DaisyAge12/GEN-SMS2VGA/README.md

# SMS2VGA
A Sega Master System/Genesis 1 RGBS output to VGA adapter

A HUGE shout out to Jeff Chen who inspired me to make this adapter with his Console VGA dongles
and who helped me make this project come to life.
