DaisyAge12/GEN-SMS2VGA/Board Images/Back View.jpg

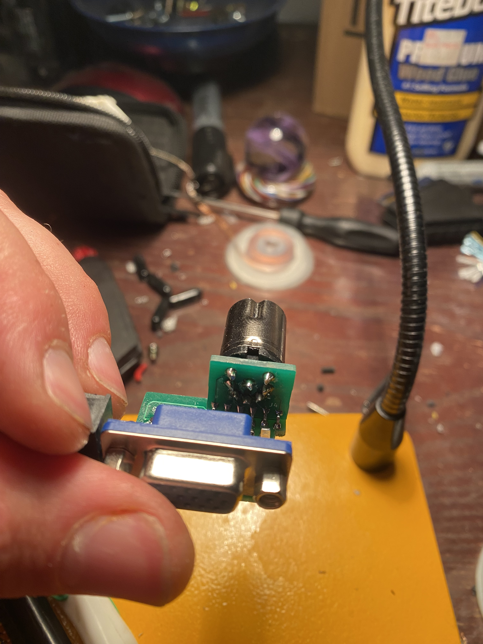
Board Images/Back View.jpg
