DaisyAge12/GEN-SMS2VGA/Board Images/DIN 8 PCB Back.jpg

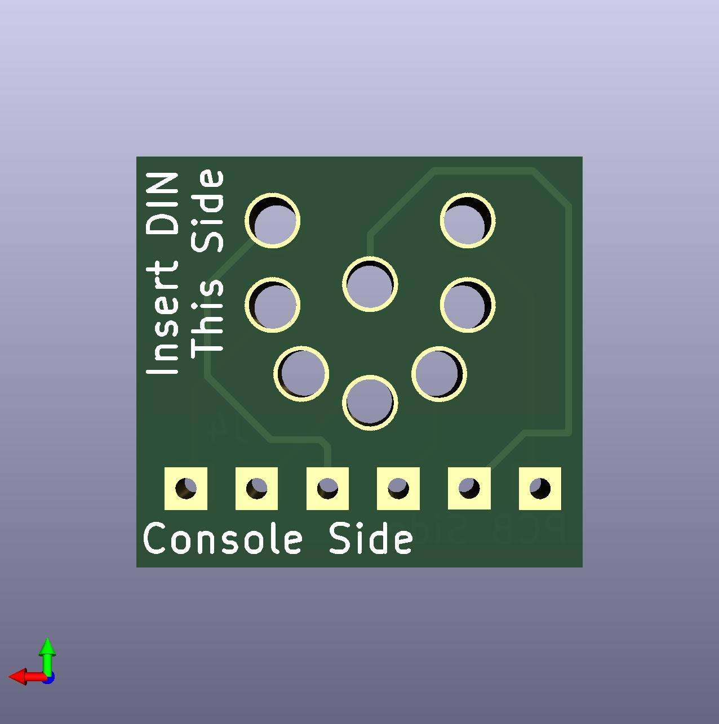
Board Images/DIN 8 PCB Back.jpg
