DaisyAge12/GEN-SMS2VGA/Board Images/DIN 8 PCB Front.jpg

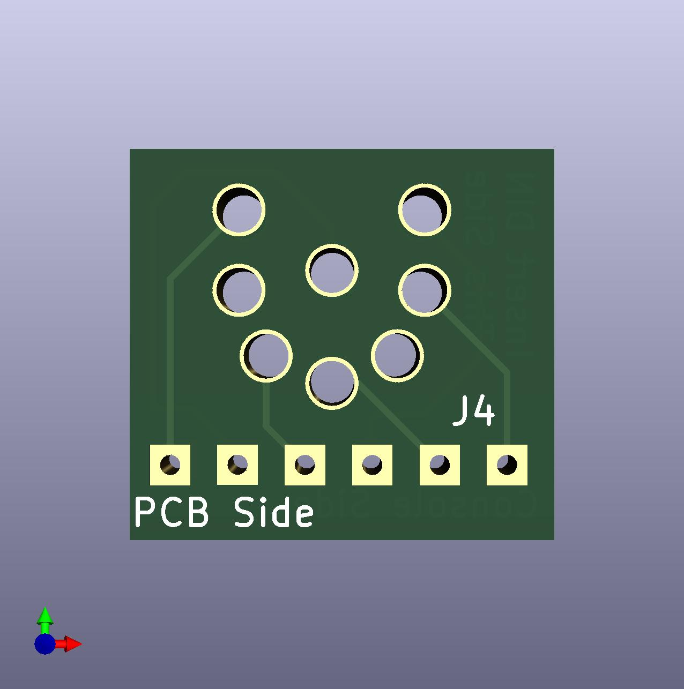
Board Images/DIN 8 PCB Front.jpg
