DaisyAge12/GEN-SMS2VGA/Board Images/SMS2VGA 2.0 Front.jpg

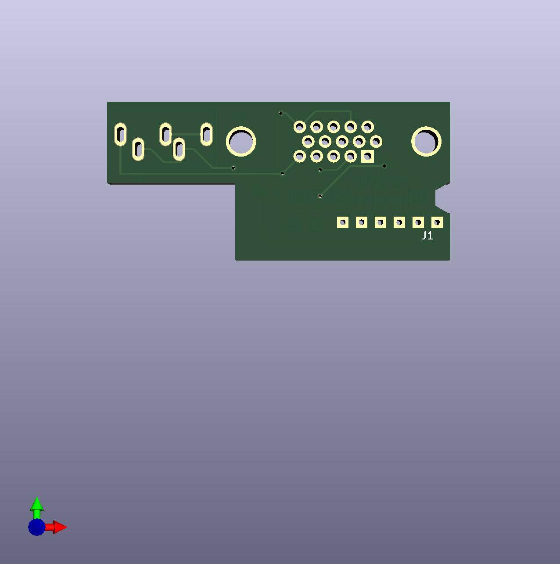
Board Images/SMS2VGA 2.0 Front.jpg
