DaisyAge12/GEN-SMS2VGA/BOM.md

Bill of Materials

M2 hex screw 20mm and nut
Quantity: 2

Right Angle Header Pins 2.54mm Spacing
Digikey part # 609-68498-122HLF-ND
Quantity: 1

Ceramic Capacitor 220UF 6.3V X5R 1206 Imperial
Digikey Part # 490-13970-1-ND
Quantity: 4

Resistor 470 OHM 5% 1/4W 0805 Imperial
Digikey Part # 2019-RK73B2ATTD471JCT-ND
Quantity: 1

Resistor 75 Ohm 1% 1/4W 0805 Imperial
Digikey Part #: 2019-RK73H2ATTD75R0FCT-ND
Quantity: 3

Vertical 3.5mm 5-Pin Audio Jack
Digikey Part # SJ1-3535N
Quantity: 1

Right Angle Female VGA Port Slim (10 pcs)
https://www.aliexpress.com/item/4000596805684.html
Quantity: 1

DIN 8 262 Degree Vertical Connector
https://www.aliexpress.us/item/3256801687296911.html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
Quantity: 1

PCB - SMS2VGA2.0
PCB - DIN 8 PCB

3D printed shell if applicable
