DaisyAge12/GEN-SMS2VGA/SMS2VGA 2.0 Bottom.stl

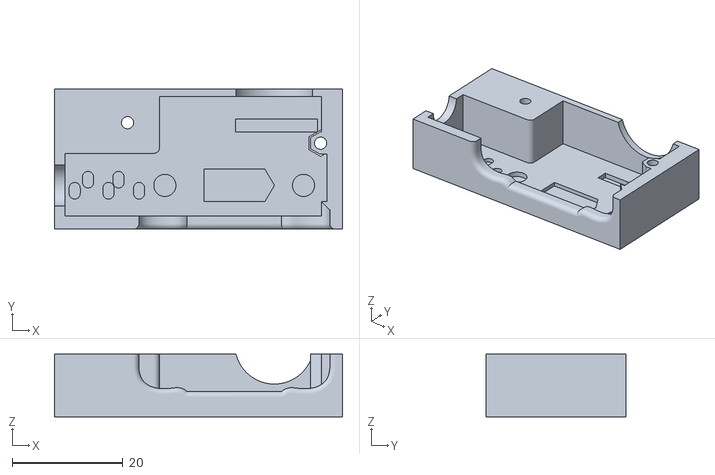
[picture p6: CAD file, 2024-01-08]
SMS2VGA 2.0 Bottom.stl
51.9 x 25.3 x 11.3
