DaisyAge12/GEN-SMS2VGA/SMS2VGA 2.0 Top.stl

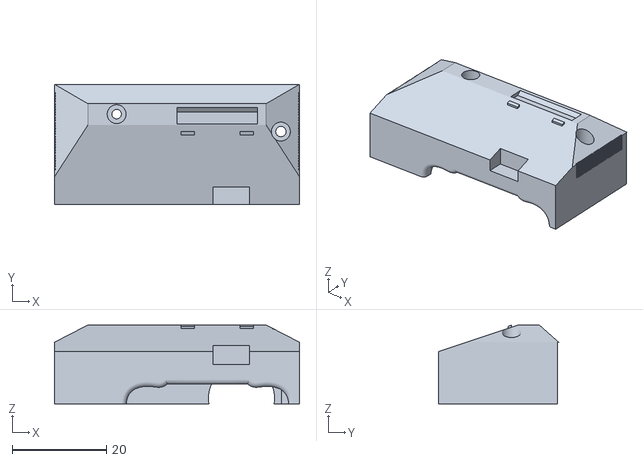
[picture p7: CAD file, 2024-01-08]
SMS2VGA 2.0 Top.stl
51.9 x 25.5 x 16.7
