DaisyAge12/GEN-SMS2VGA/(commit log)

2023-10-15 Create BOM
2023-10-15 PCB files
2023-10-15 Create Assembly
    Outline
2023-10-15 Upload New PCB Design
2023-10-15 PCB views
2023-10-20 Update BOM
2023-10-20 Updated PCB Design
    Renamed files, etc.
2023-10-20 Updated Assembly
2023-11-01 Design Overhaul
    Removed old PCB design, updated to new DIN 8 vertical pcb mount connector. Added STL files for 3D printed shell, updated BOM, assembly, added new photos.
    [SMS2VGA 2.0 Bottom.stl, SMS2VGA 2.0 Top.stl]
2023-11-02 STL redesign
    Updated shell tolerances
    [SMS2VGA 2.0 Top.stl, SMS2VGA 2.0 Bottom.stl, SMS2VGA 2.0 Bottom.stl, SMS2VGA 2.0 Top.stl]
2023-11-04 Updated tolerances for screws and nuts
    [SMS2VGA 2.0 Top.stl, SMS2VGA 2.0 Bottom.stl, SMS2VGA 2.0 Bottom.stl, SMS2VGA 2.0 Top.stl]
2023-11-04 Update SMS2VGA 2.0 Bottom.stl
    [SMS2VGA 2.0 Bottom.stl]
2024-01-08 Updated Files
    Tolerance fixed for M2 Nuts, new PCB files uploaded to fix audio issues.
    [SMS2VGA 2.0 Bottom.stl, SMS2VGA 2.0 Top.stl]
2024-01-08 Fixed BOM
